williavs/typedeck-keyboard/plates/plates.png

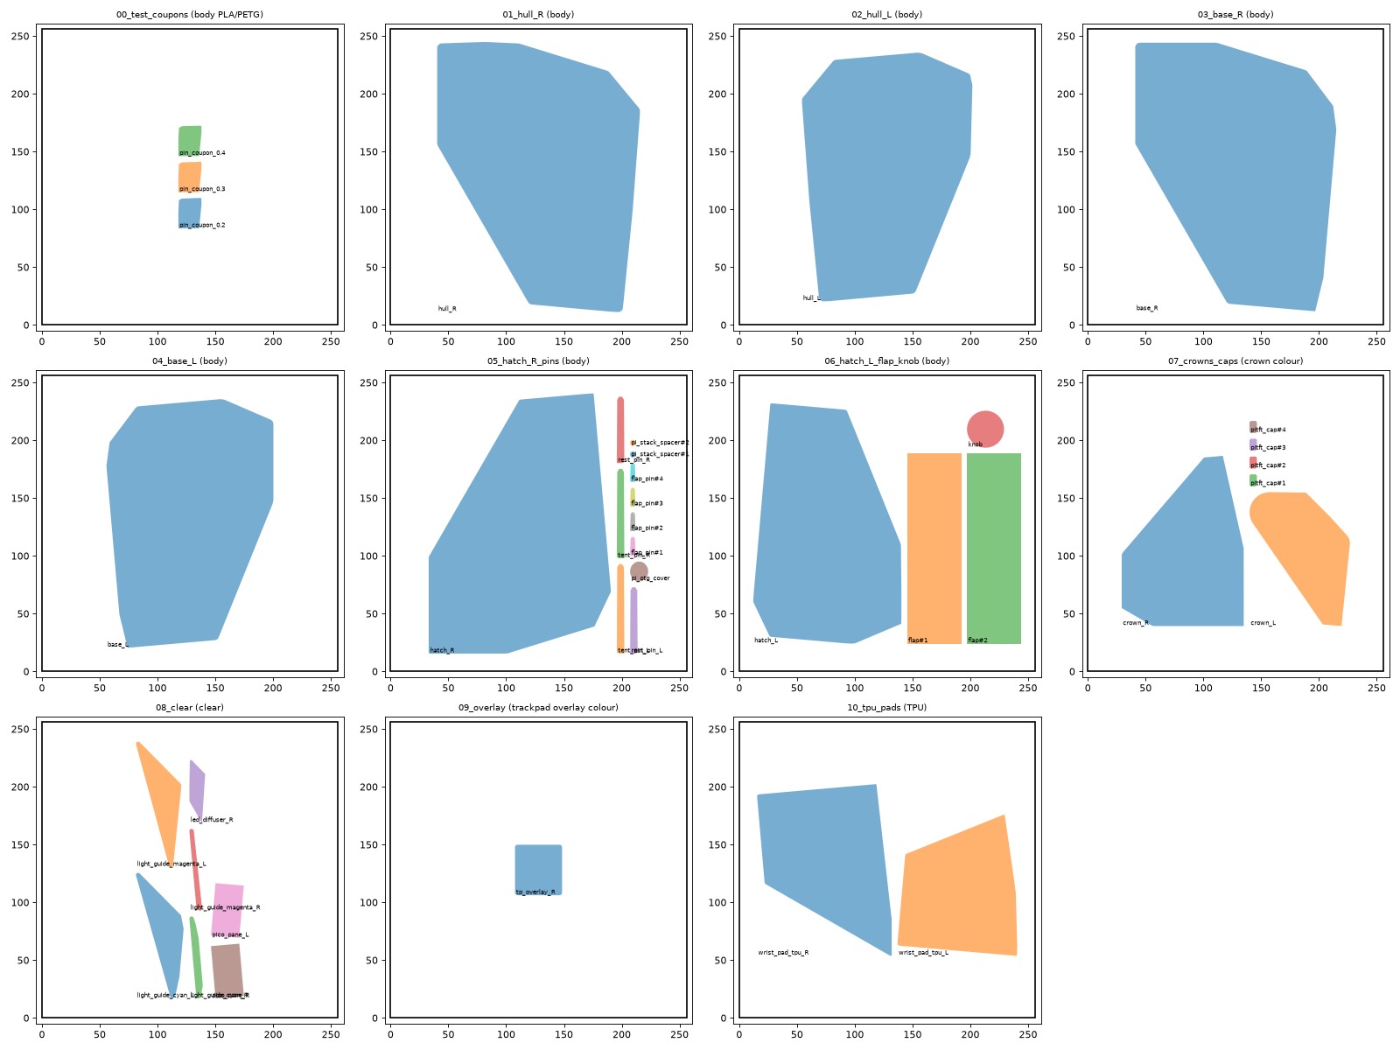
plates/plates.png
