williavs/typedeck-keyboard/plates/05_hatch_R_pins.3mf

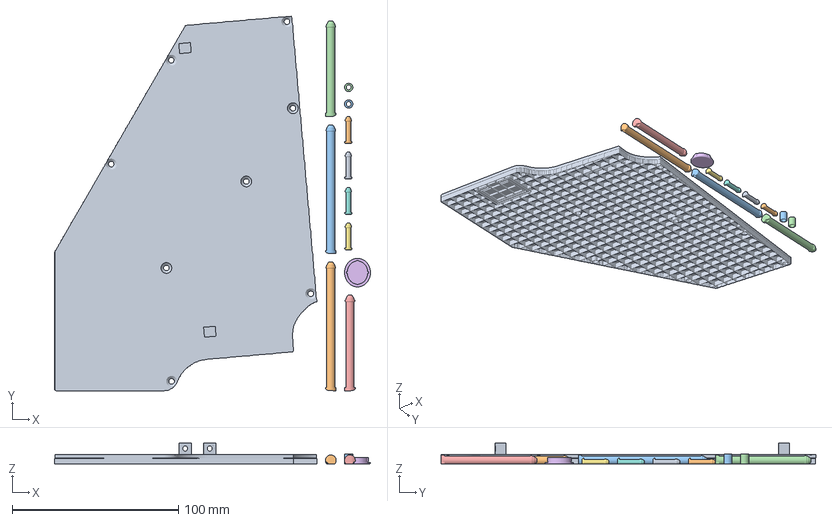
[picture p12: CAD file, 2026-10-17]
plates/05_hatch_R_pins.3mf
189.9 x 225.1 x 12.5 mm
velvet_hatch_R
velvet_tent_pin_L
velvet_tent_pin_R
velvet_rest_pin_R
velvet_rest_pin_L
velvet_pi_otg_cover
velvet_flap_pin#1
velvet_flap_pin#2
velvet_flap_pin#3
velvet_flap_pin#4
velvet_pi_stack_spacer#1
velvet_pi_stack_spacer#2
