williavs/typedeck-keyboard/stl/velvet_wrist_pad_tpu_L.stl

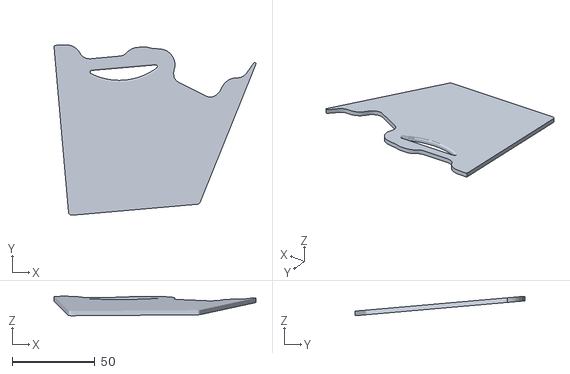
[picture p13: CAD file, 2026-10-17]
stl/velvet_wrist_pad_tpu_L.stl
122.0 x 103.0 x 11.8
