williavs/typedeck-keyboard/plates/04_base_L.3mf

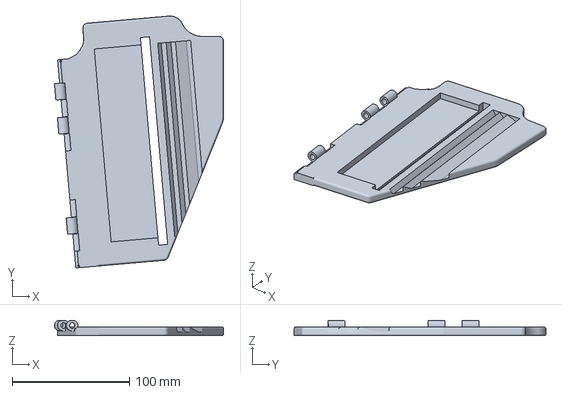
[picture p14: CAD file, 2026-10-17]
plates/04_base_L.3mf
144.5 x 215.1 x 13.1 mm
