williavs/typedeck-keyboard/stl/velvet_base_R.stl

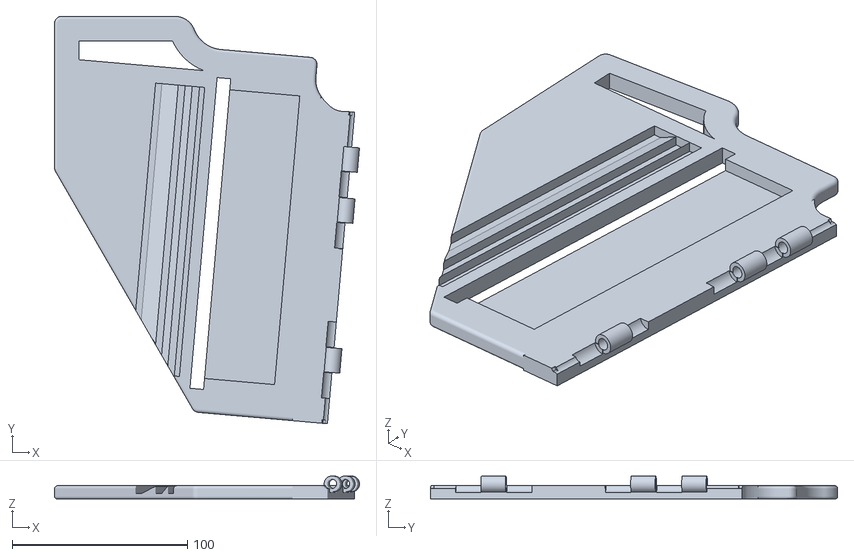
[picture p15: CAD file, 2026-10-17]
stl/velvet_base_R.stl
174.0 x 232.4 x 13.1
