williavs/typedeck-keyboard/plates/06_hatch_L_flap_knob.3mf

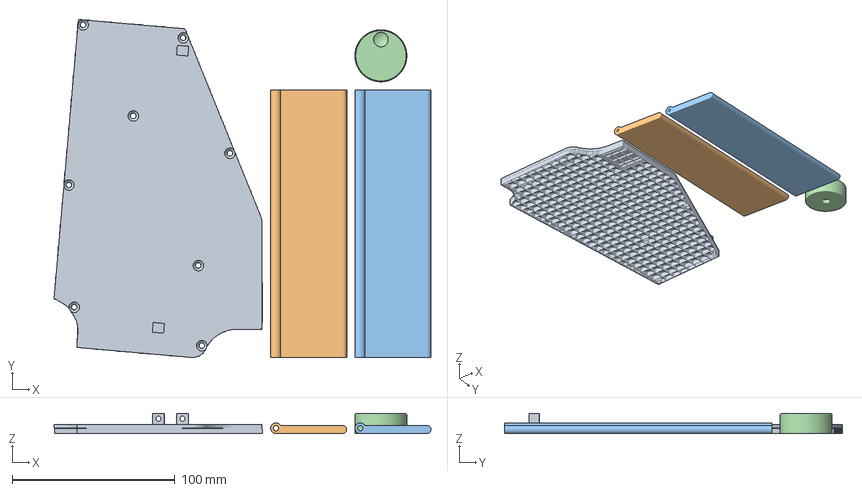
[picture p16: CAD file, 2026-10-17]
plates/06_hatch_L_flap_knob.3mf
231.8 x 207.8 x 12.5 mm
velvet_hatch_L
velvet_flap#1
velvet_flap#2
velvet_knob
