williavs/typedeck-keyboard/stl/velvet_knob.stl

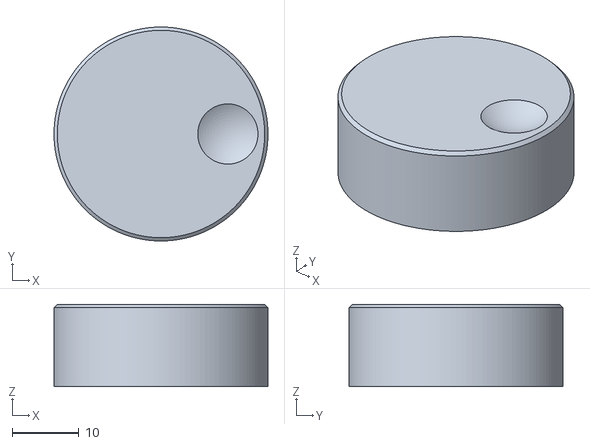
[picture p17: CAD file, 2026-10-17]
stl/velvet_knob.stl
32.0 x 32.0 x 12.3
