williavs/typedeck-keyboard/plates/00_test_coupons.3mf

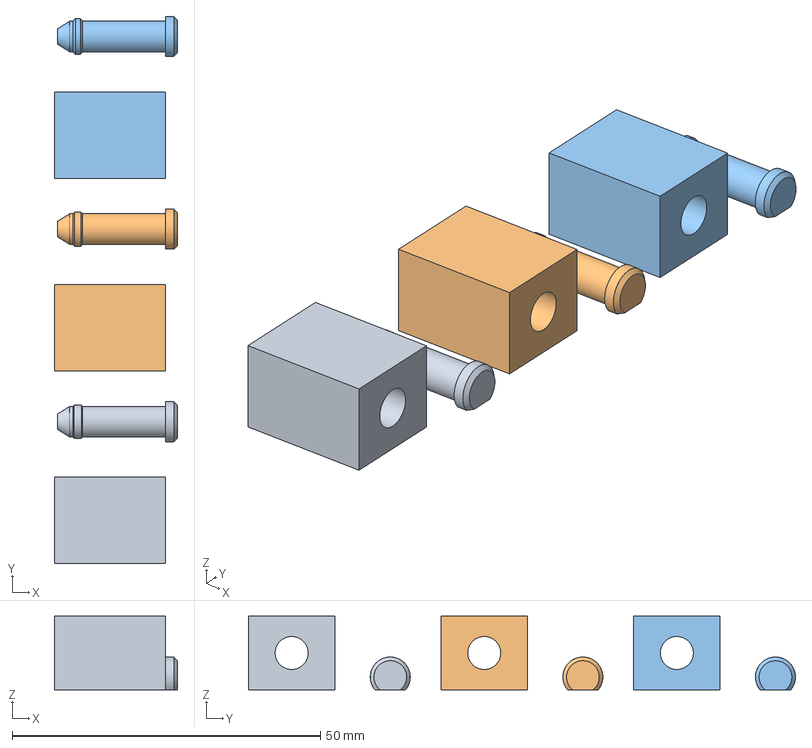
[picture p18: CAD file, 2026-10-17]
plates/00_test_coupons.3mf
20.0 x 88.7 x 12.0 mm
velvet_pin_coupon_0.2
velvet_pin_coupon_0.3
velvet_pin_coupon_0.4
