williavs/typedeck-keyboard/plates/08_clear.3mf

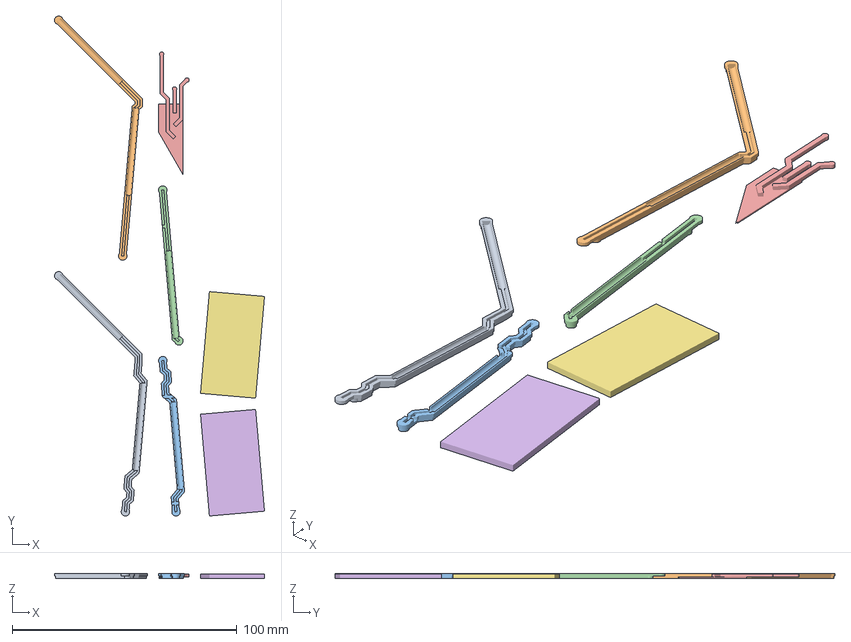
[picture p19: CAD file, 2026-10-17]
plates/08_clear.3mf
93.4 x 222.2 x 2.30 mm
velvet_light_guide_cyan_L
velvet_light_guide_magenta_L
velvet_light_guide_cyan_R
velvet_light_guide_magenta_R
velvet_led_diffuser_R
velvet_pico_pane_R
velvet_pico_pane_L
