williavs/typedeck-keyboard/stl/velvet_hull_L.stl

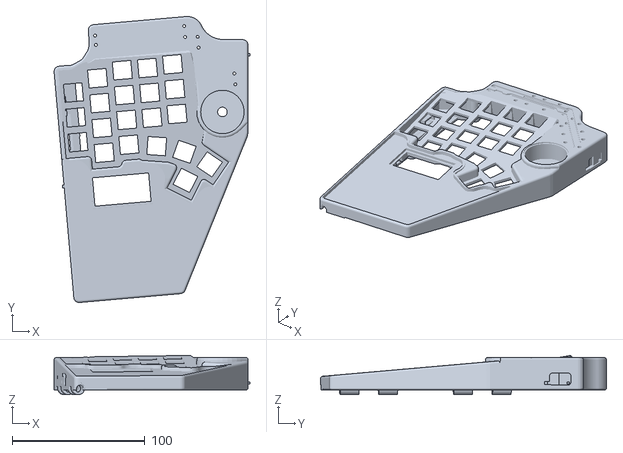
[picture p20: CAD file, 2026-10-17]
stl/velvet_hull_L.stl
147.3 x 215.2 x 29.4
