williavs/typedeck-keyboard/plates/10_tpu_pads.3mf

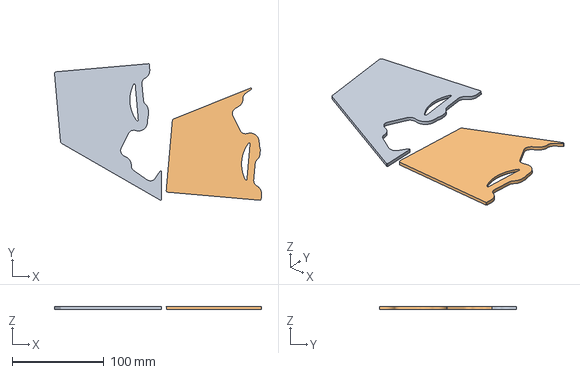
[picture p21: CAD file, 2026-10-17]
plates/10_tpu_pads.3mf
225.1 x 148.5 x 2.79 mm
velvet_wrist_pad_tpu_R
velvet_wrist_pad_tpu_L
