williavs/typedeck-keyboard/stl/velvet_tent_pin_R.stl

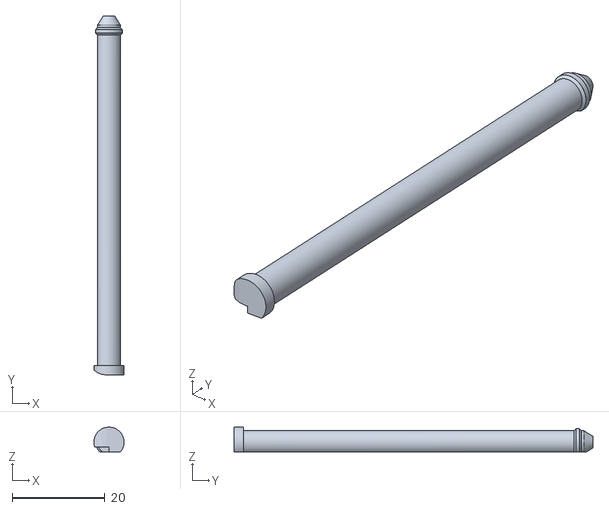
[picture p22: CAD file, 2026-10-17]
stl/velvet_tent_pin_R.stl
6.50 x 77.4 x 5.35
