williavs/typedeck-keyboard/plates/02_hull_L.3mf

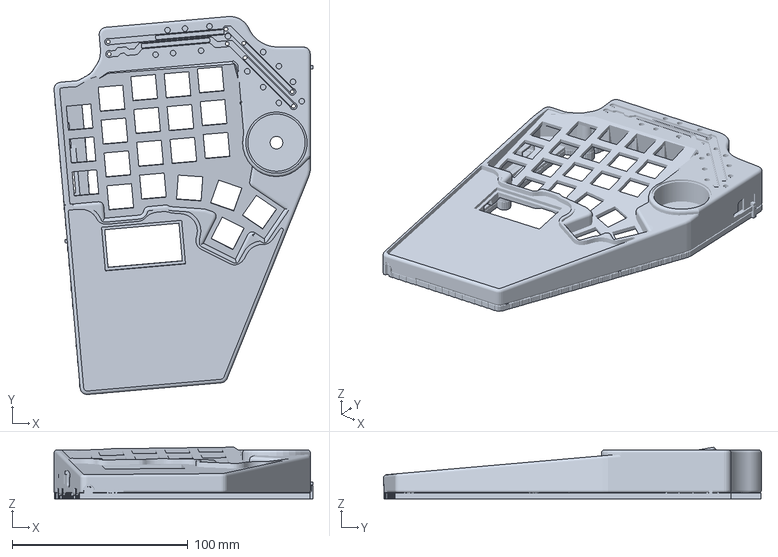
[picture p23: CAD file, 2026-10-17]
plates/02_hull_L.3mf
147.4 x 215.2 x 29.4 mm
