williavs/typedeck-keyboard/stl/velvet_pitft_cap.stl

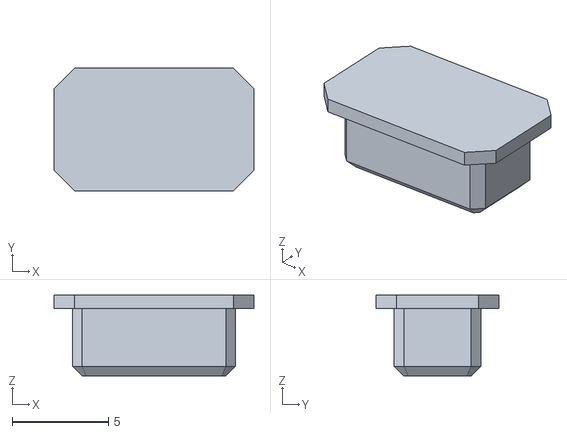
[picture p24: CAD file, 2026-10-17]
stl/velvet_pitft_cap.stl
10.4 x 6.40 x 4.20
