williavs/typedeck-keyboard/plates/01_hull_R.3mf

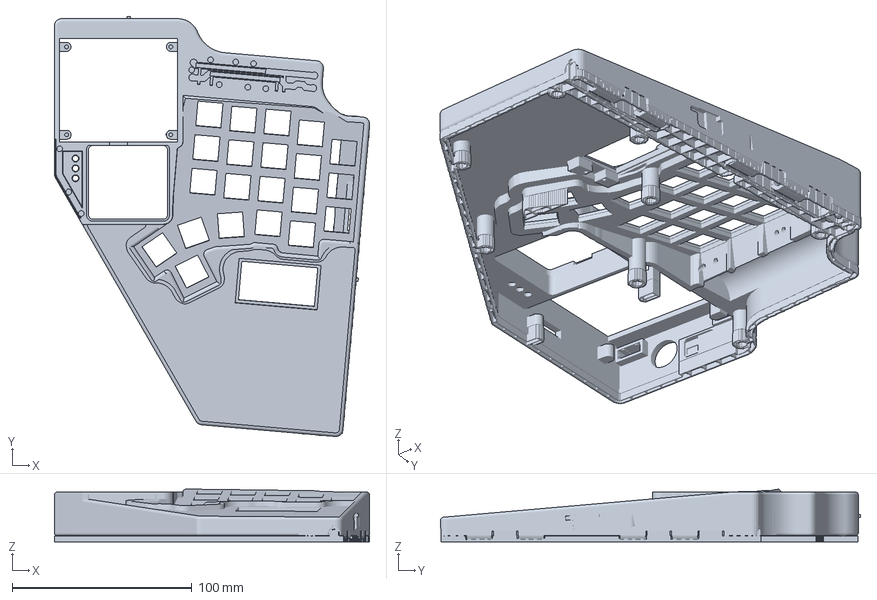
[picture p25: CAD file, 2026-10-17]
plates/01_hull_R.3mf
175.4 x 233.7 x 29.4 mm
