williavs/typedeck-keyboard/stl/velvet_crown_L.stl

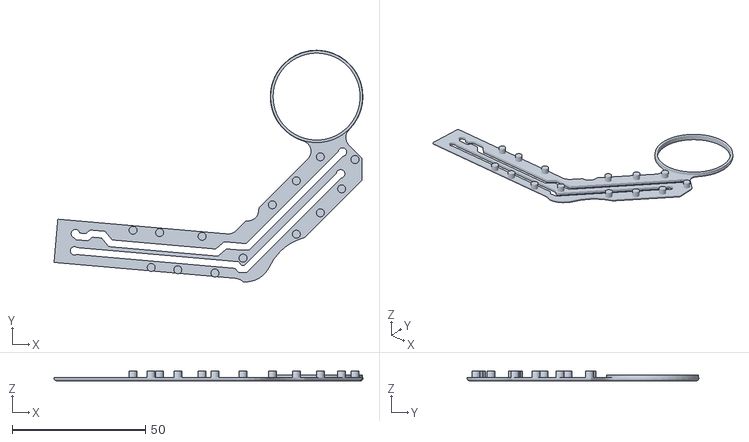
[picture p26: CAD file, 2026-10-17]
stl/velvet_crown_L.stl
115.9 x 86.9 x 3.70
