williavs/typedeck-keyboard/stl/velvet_light_guide_magenta_R.stl

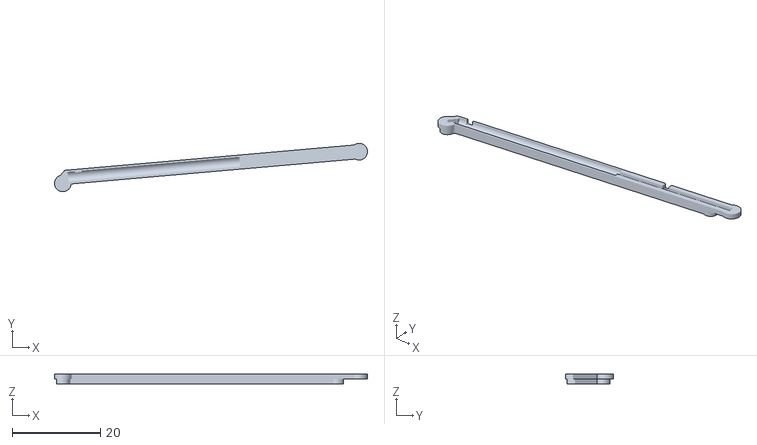
[picture p27: CAD file, 2026-10-17]
stl/velvet_light_guide_magenta_R.stl
70.8 x 11.0 x 2.30
