williavs/typedeck-keyboard/plates/09_overlay.3mf

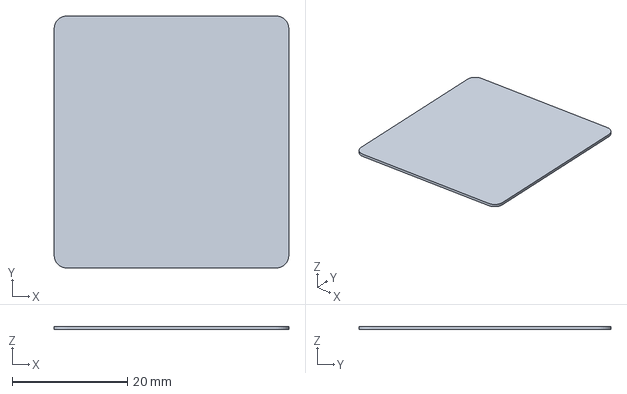
[picture p28: CAD file, 2026-10-17]
plates/09_overlay.3mf
40.7 x 43.7 x 0.6 mm
