williavs/typedeck-keyboard/stl/velvet_pico_pane_L.stl

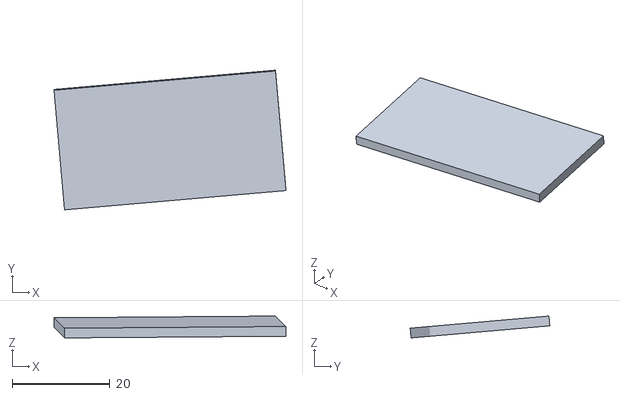
[picture p29: CAD file, 2026-10-17]
stl/velvet_pico_pane_L.stl
47.4 x 28.5 x 4.47
