williavs/typedeck-keyboard/plates/07_crowns_caps.3mf

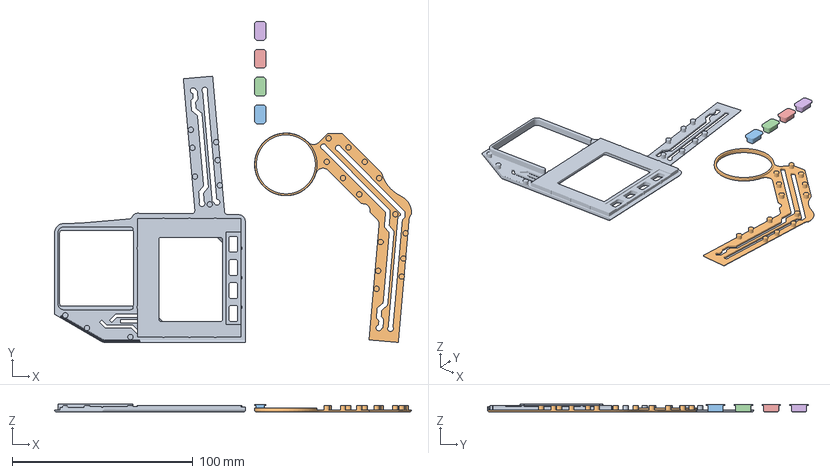
[picture p30: CAD file, 2026-10-17]
plates/07_crowns_caps.3mf
197.5 x 177.5 x 4.43 mm
velvet_crown_R
velvet_crown_L
velvet_pitft_cap#1
velvet_pitft_cap#2
velvet_pitft_cap#3
velvet_pitft_cap#4
