williavs/typedeck-keyboard/stl/velvet_wrist_pad_tpu_R.stl

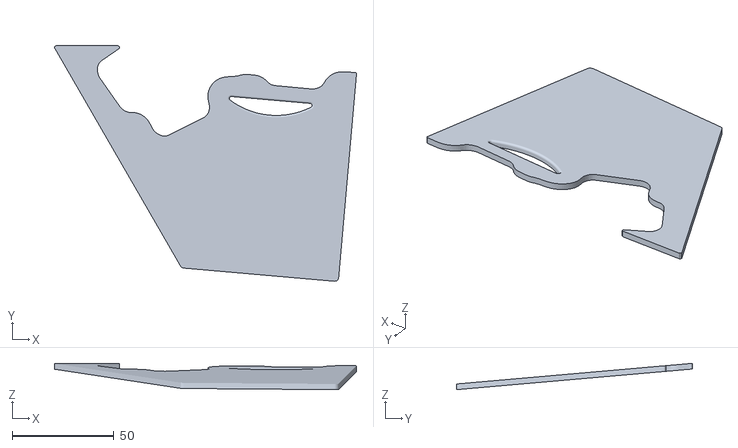
[picture p31: CAD file, 2026-10-17]
stl/velvet_wrist_pad_tpu_R.stl
148.5 x 115.8 x 12.9
