williavs/typedeck-keyboard/stl/velvet_rest_pin_L.stl

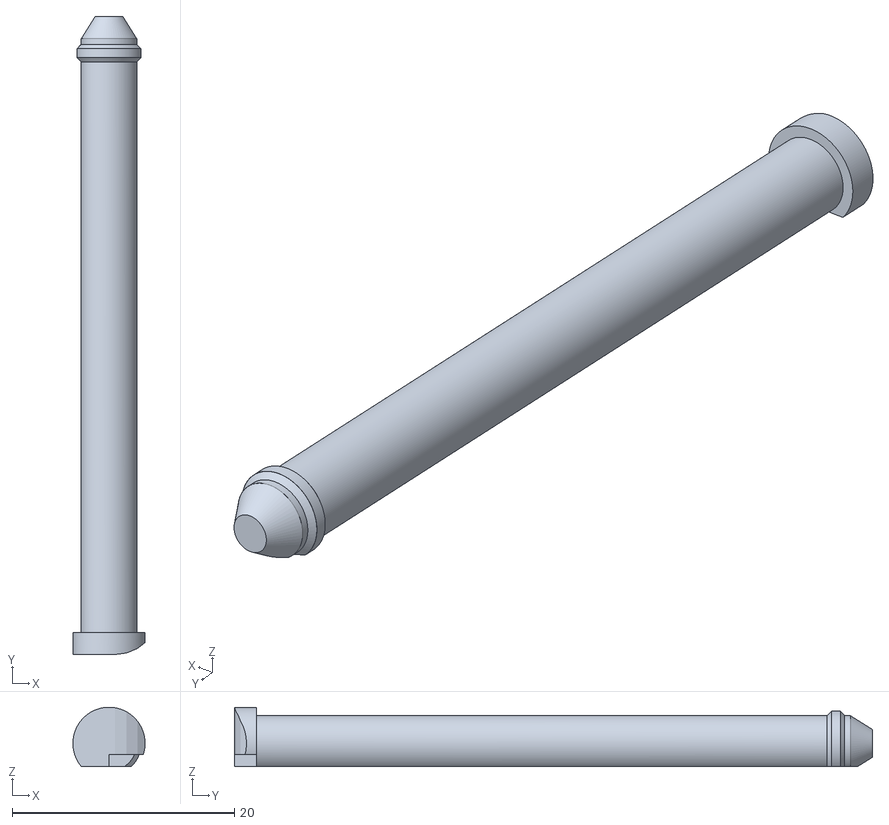
[picture p32: CAD file, 2026-10-17]
stl/velvet_rest_pin_L.stl
6.50 x 57.4 x 5.35
