williavs/typedeck-keyboard/stl/velvet_light_guide_cyan_L.stl

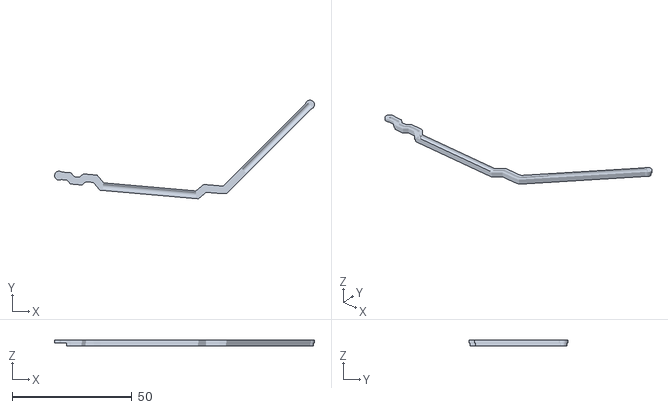
[picture p33: CAD file, 2026-10-17]
stl/velvet_light_guide_cyan_L.stl
108.7 x 41.2 x 2.30
