williavs/typedeck-keyboard/stl/velvet_pin_coupon_0.3.stl

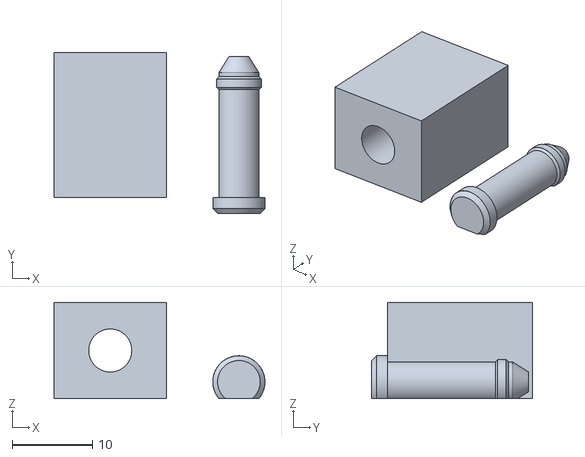
[picture p34: CAD file, 2026-10-17]
stl/velvet_pin_coupon_0.3.stl
26.2 x 20.0 x 12.0
