williavs/typedeck-keyboard/stl/velvet_led_diffuser_R.stl

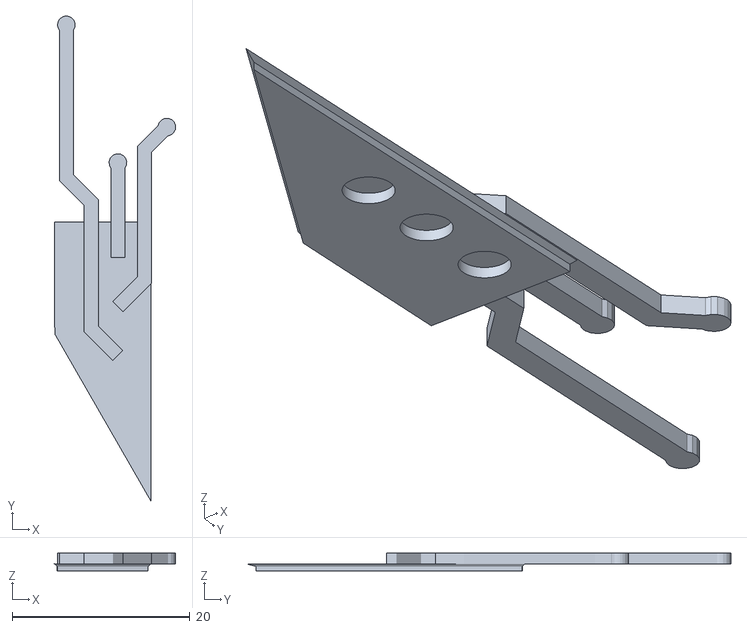
[picture p35: CAD file, 2026-10-17]
stl/velvet_led_diffuser_R.stl
13.7 x 54.6 x 2.00
