williavs/typedeck-keyboard/stl/velvet_pi_stack_spacer.stl

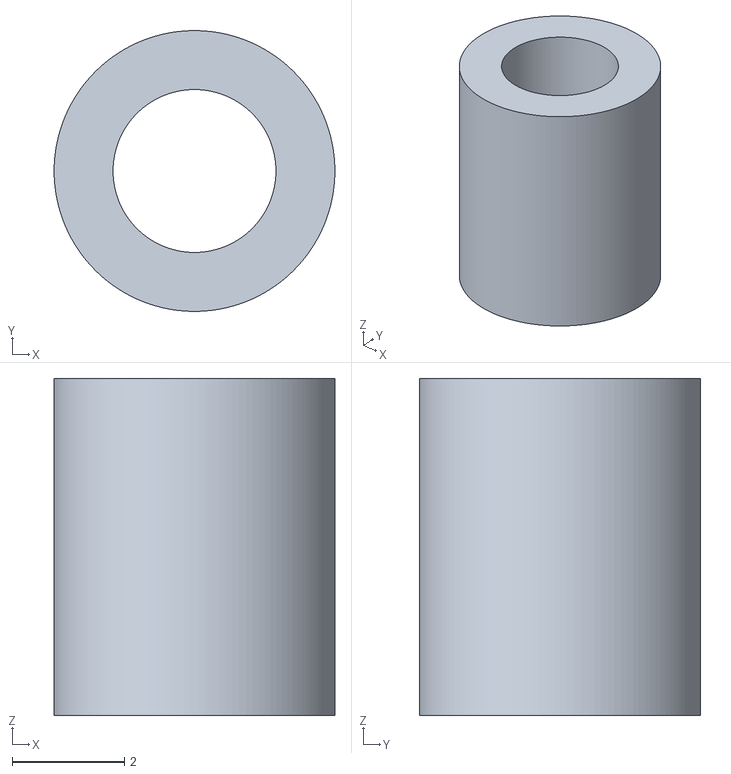
[picture p36: CAD file, 2026-10-17]
stl/velvet_pi_stack_spacer.stl
5.00 x 5.00 x 6.00
