williavs/typedeck-keyboard/stl/velvet_light_guide_cyan_R.stl

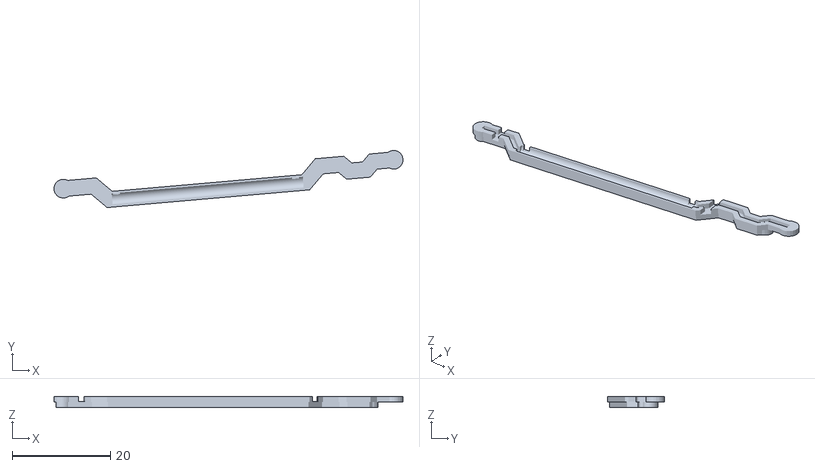
[picture p37: CAD file, 2026-10-17]
stl/velvet_light_guide_cyan_R.stl
70.9 x 11.6 x 2.30
