williavs/typedeck-keyboard/stl/velvet_hull_R.stl

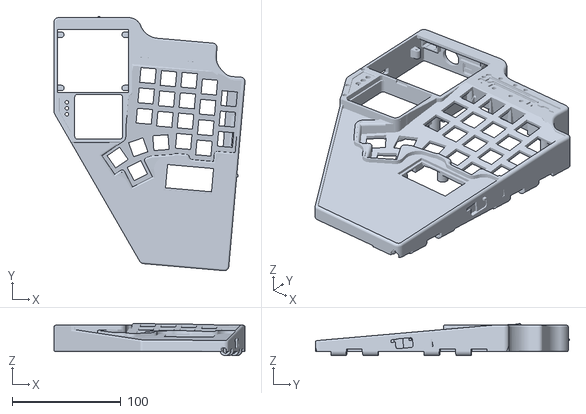
[picture p38: CAD file, 2026-10-17]
stl/velvet_hull_R.stl
175.4 x 233.7 x 29.4
