williavs/typedeck-keyboard/stl/velvet_pi_otg_cover.stl

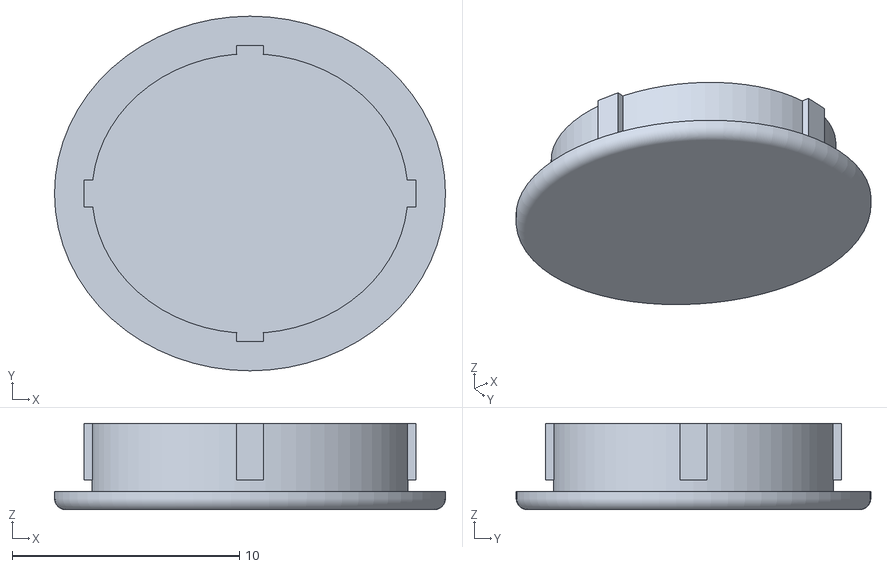
[picture p39: CAD file, 2026-10-17]
stl/velvet_pi_otg_cover.stl
17.2 x 15.6 x 3.80
