williavs/typedeck-keyboard/stl/velvet_flap_pin.stl

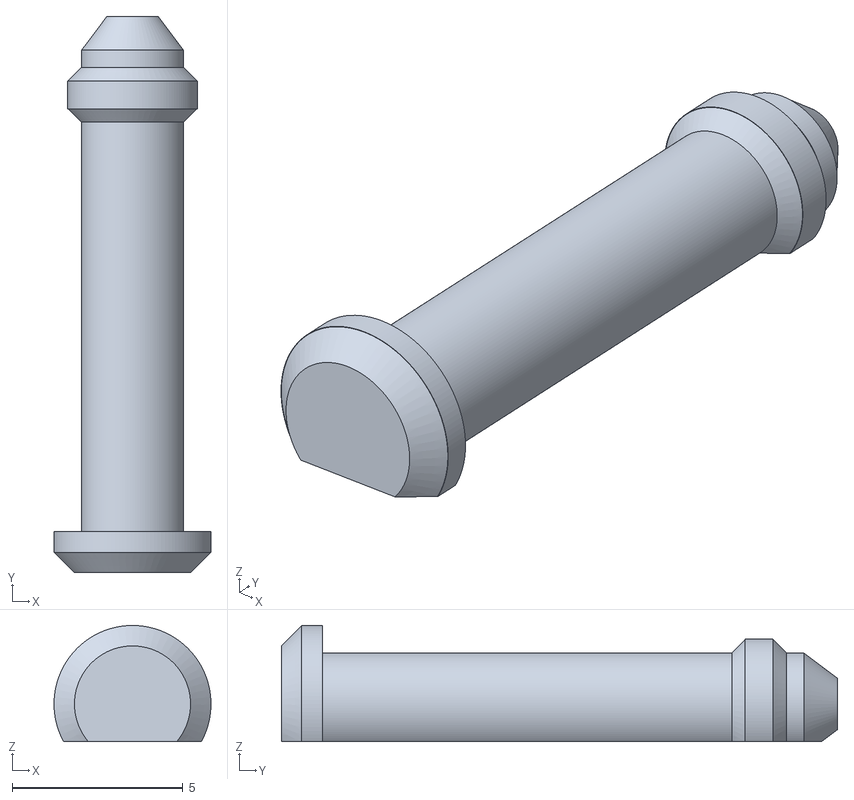
[picture p40: CAD file, 2026-10-17]
stl/velvet_flap_pin.stl
4.60 x 16.3 x 3.40
