williavs/typedeck-keyboard/stl/velvet_flap.stl

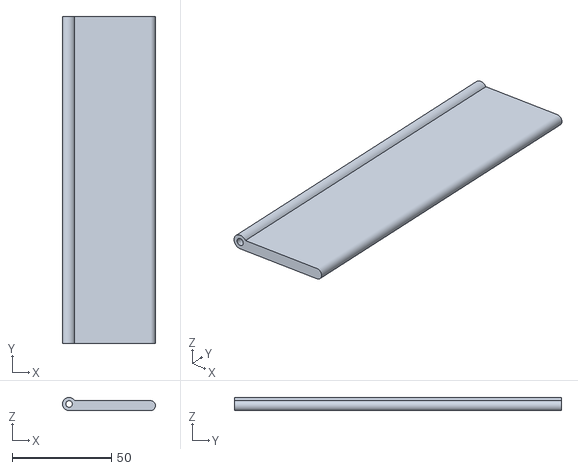
[picture p41: CAD file, 2026-10-17]
stl/velvet_flap.stl
46.8 x 164.5 x 6.60
