williavs/typedeck-keyboard/stl/velvet_hatch_L.stl

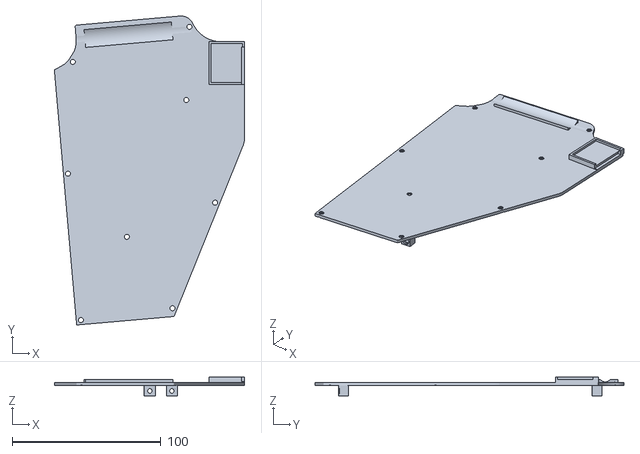
[picture p42: CAD file, 2026-10-17]
stl/velvet_hatch_L.stl
128.0 x 207.8 x 12.5
