williavs/typedeck-keyboard/stl/velvet_crown_R.stl

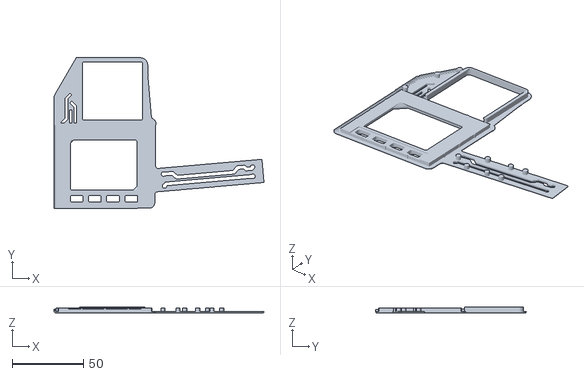
[picture p43: CAD file, 2026-10-17]
stl/velvet_crown_R.stl
147.3 x 105.6 x 4.43
