williavs/typedeck-keyboard/stl/velvet_hatch_R.stl

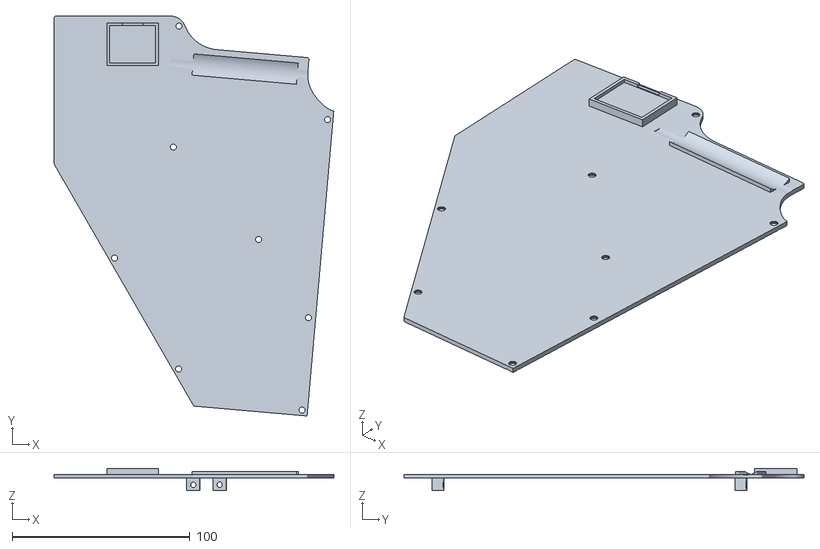
[picture p44: CAD file, 2026-10-17]
stl/velvet_hatch_R.stl
157.3 x 225.1 x 12.5
