williavs/typedeck-keyboard/stl/velvet_light_guide_magenta_L.stl

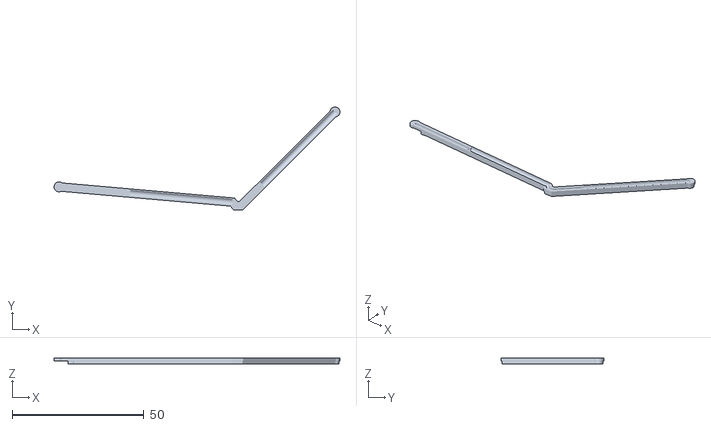
[picture p45: CAD file, 2026-10-17]
stl/velvet_light_guide_magenta_L.stl
108.6 x 39.1 x 2.30
