williavs/typedeck-keyboard/(list of files, cad)

Other CAD files:
stl/velvet_base_L.stl
plates/03_base_R.3mf
stl/velvet_tent_pin_L.stl
stl/velvet_pico_pane_R.stl
stl/velvet_rest_pin_R.stl
stl/velvet_tp_overlay_R.stl
stl/velvet_pin_coupon_0.4.stl
stl/velvet_pin_coupon_0.2.stl
